userofmeet/TaRANG/README.md

# TaRANG

This repository contains the work I do at EMSys Lab, IIT Bombay, as a Research Assistant during my master's, under the guidance of Prof. Maryam Shojaei Baghini.

It serves as a place to keep the datasheets, research papers, code, and other technical resources related to my work.

## Contents

- Datasheets and technical documentation
- Research papers and references
- Code and implementations
- Experiments and analysis
- Notes and other useful resources

The repository will be updated as I continue working on different tasks and projects in the lab.
