userofmeet/TaRANG/MagniSense_Sys_1V1/Readings/output/print_02_plot.png

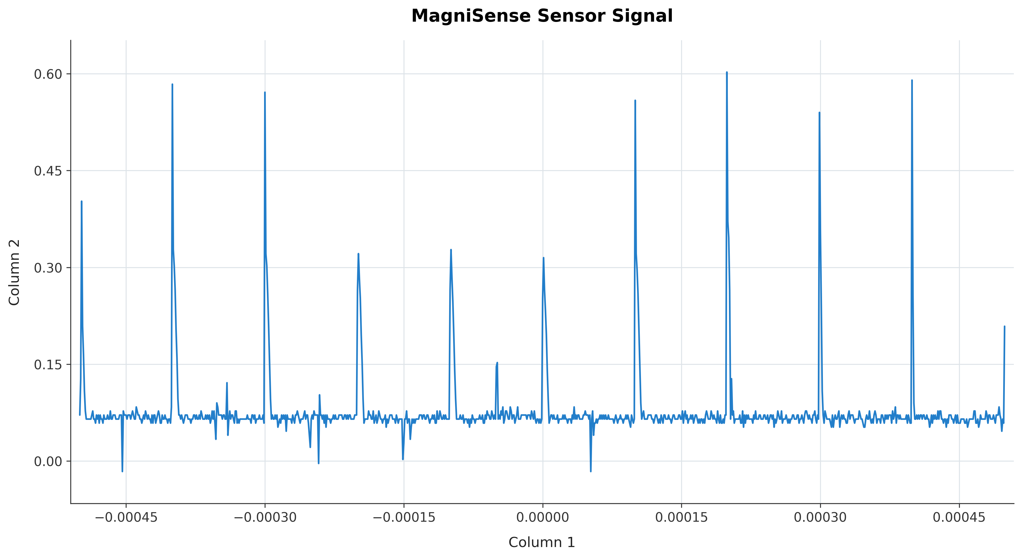
MagniSense_Sys_1V1/Readings/output/print_02_plot.png
