userofmeet/TaRANG/MagniSense_Sys_1V1/Readings/output/print_03_plot.png

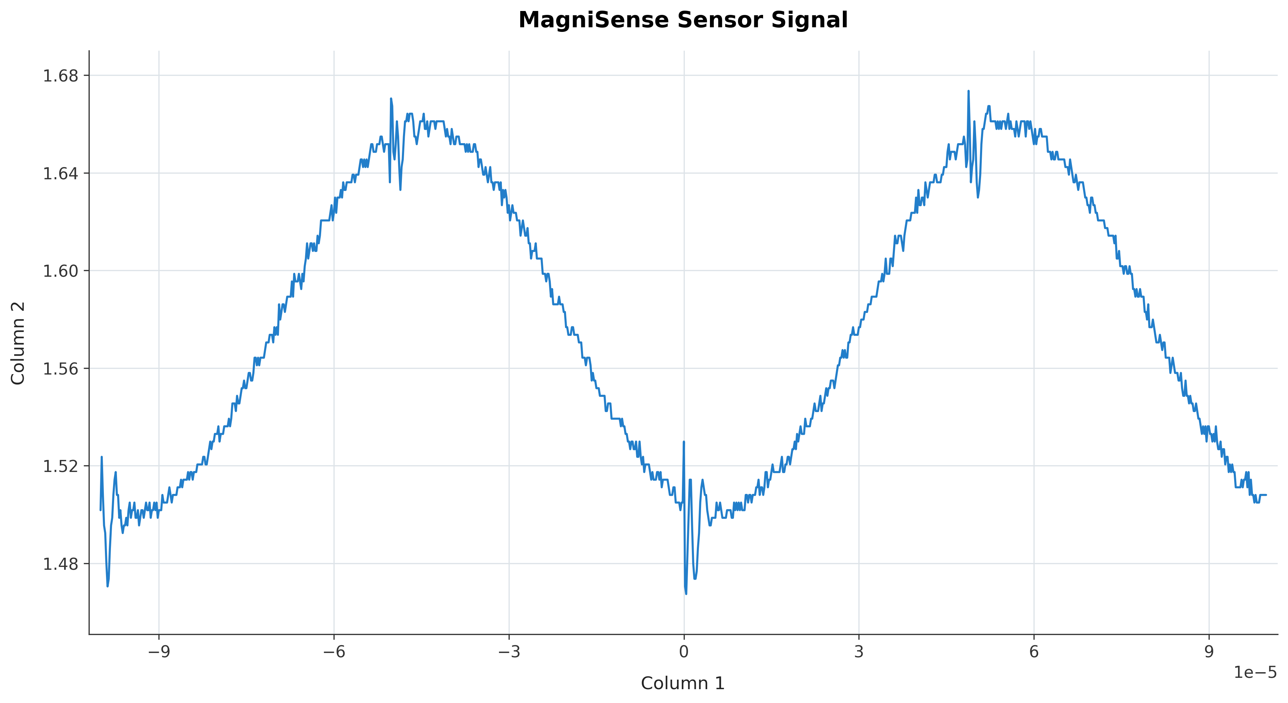
MagniSense_Sys_1V1/Readings/output/print_03_plot.png
