userofmeet/TaRANG/MagniSense_Sys_1V1/INA_Characterization.xlsx

INA1 CHARACTERIZATION MAGNISENSE V1 |  |  |  |  |  | INA1 CHARACTERIZATION MAGNISENSE V1
 | p2p | max(m) | min(m) | DC offset | VERDICT |  | p2p | max | min | DC offset | VERDICT | unit
50 | 0.06331 | 0.37488 | 0.31157 | 0.343225 | COMPLETELY SATURATED | 50 | 0.01 | 3.24 | 3.23 | 3.235 | SATURATION | (v)
1K | 0.01 | 0.51151 | 0.3249 | 0.418205 | COMPLETELY SATURATED | 1K | 0 |  |  | 0
2K | 0.18661 | 0.4282 | 0.4182 | 0.4232 | COMPLETELY SATURATED | 2K | 0 |  |  | 0
4K | 0.41098 | 0.66932 | 0.25834 | 0.46383 | SATURATED | 4K | 0 |  |  | 0
6K | 0.950729 | 0.97423 | 0.023501 | 0.4988655 | SATURATED | 6K | 0 |  |  | 0
8K | 0.98137 | 1.1425 | 0.16113 | 0.651815 |  | 8K | 0 |  |  | 0
10K | 0.68019 | 1.1239 | 0.44371 | 0.783805 |  | 10K | 0 |  |  | 0
15K | 0.60348 | 1.3651 | 0.76162 | 1.06336 |  | 15K | 0 |  |  | 0
20K | 0.47082 | 1.4044 | 0.93358 | 1.16899 |  | 20K | 0 |  |  | 0
25K | 0.4192 | 1.4501 | 1.0309 | 1.2405 |  | 25K | 0 |  |  | 0
30K | 0.3642 | 1.4684 | 1.1042 | 1.2863 |  | 30K | 0 |  |  | 0
35K | 0.3316 | 1.4861 | 1.1545 | 1.3203 |  | 35K | 0 |  |  | 0
40K | 0.3139 | 1.4967 | 1.1828 | 1.33975 |  | 40K | 1.46 | 3.28 | 1.82 | 2.55 |  | v
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
