userofmeet/TaRANG/MagniSense_Sys_1V1/DigiPOT/digipot_characterization.csv

sent_res_kohm | expected_res_kohm | measured_dmm_kohm | measured_smd_kohm
2.570 | 2.589 | 2.446 | 2.448
3.070 | 2.980 | 2.812 | 2.820
3.570 | 3.565 | 3.290 | 3.320
4.070 | 4.151 | 3.855 | 3.840
4.570 | 4.542 | 4.220 | 4.230
4.490 | 4.542 | 4.220 | 4.240
4.990 | 4.932 | 4.580 | 4.610
5.490 | 5.518 | 5.130 | 5.130
5.990 | 5.909 | 5.490 | 5.500
6.490 | 6.495 | 6.080 | 6.100
11.400 | 11.378 | 10.680 | 10.740
11.900 | 11.964 | 11.230 | 11.280
12.400 | 12.354 | 11.610 | 11.650
12.900 | 12.940 | 12.200 | 12.210
13.400 | 13.331 | 12.560 | 12.620
48.400 | 48.487 | 45.300 | 45.500
48.900 | 48.878 | 45.600 | 45.900
49.400 | 49.464 | 46.200 | 46.400
49.900 | 49.854 | 46.600 | 46.800
50.400 | 49.854 | 46.600 | 46.800
