userofmeet/TaRANG/MagniSense_Sys_1V1/DigiPOT/digipot_characterization.xlsx

EXPECTED RES | CALCULATED RES | MEASURED RES DMM | MEASURED RES SMD | VALUE AFTER CALIB |  | RES MEASURED (SMD)
2.57K | 2.589K | 2.446K | 2.448K
3.07K | 2.98K | 2.812K | 2.82K
3.57K | 3.565K | 3.29K | 3.32K | 3750 | 3950 | 3.47K | 3.65K
4.07k | 4.151K | 3.855K | 3.84K
4.57K | 4.542K | 4.22K | 4.23K
4.49K | 4.542K | 4.22K | 4.24K
4.99K | 4.932K | 4.58K | 4.61K
5.49K | 5.518K | 5.13K | 5.13K | 5800 | 5900 | 5.33K | 5.50K
5.99K | 5.909K | 5.49K | 5.5K
6.49K | 6.495K | 6.08K | 6.1K
11.4K | 11.378K | 10.68K | 10.74K
11.9K | 11.964K | 11.23K | 11.28K
12.4K | 12.354K | 11.61K | 11.65K | 13000 | 13080 | 12.22K | 12.41K
12.9K | 12.94K | 12.20K | 12.21K
13.4K | 13.331K | 12.56K | 12.62K
48.4K | 48.487K | 45.3K | 45.5K
48.9K | 48.878K | 45.6K | 45.9K
49.4K | 49.464K | 46.2K | 46.4K | 50000 |  | 46.8K
49.9K | 49.854K | 46.6K | 46.8K
50.4K | 49.854K | 46.6K | 46.8K
