userofmeet/TaRANG/MagniSense_Sys_1V1/DigiPOT/dmm_calibration.png

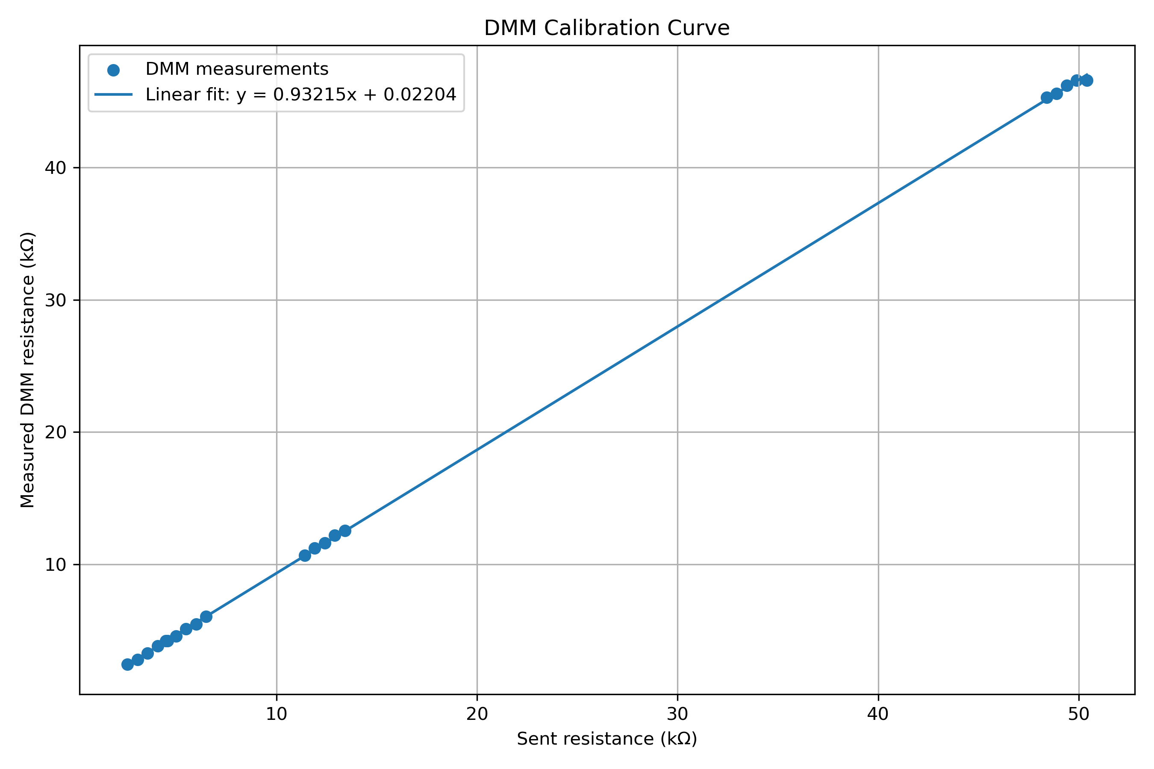
MagniSense_Sys_1V1/DigiPOT/dmm_calibration.png
