userofmeet/TaRANG/MagniSense_Sys_1V1/MagniS4ense_Sys_1V1.pdf

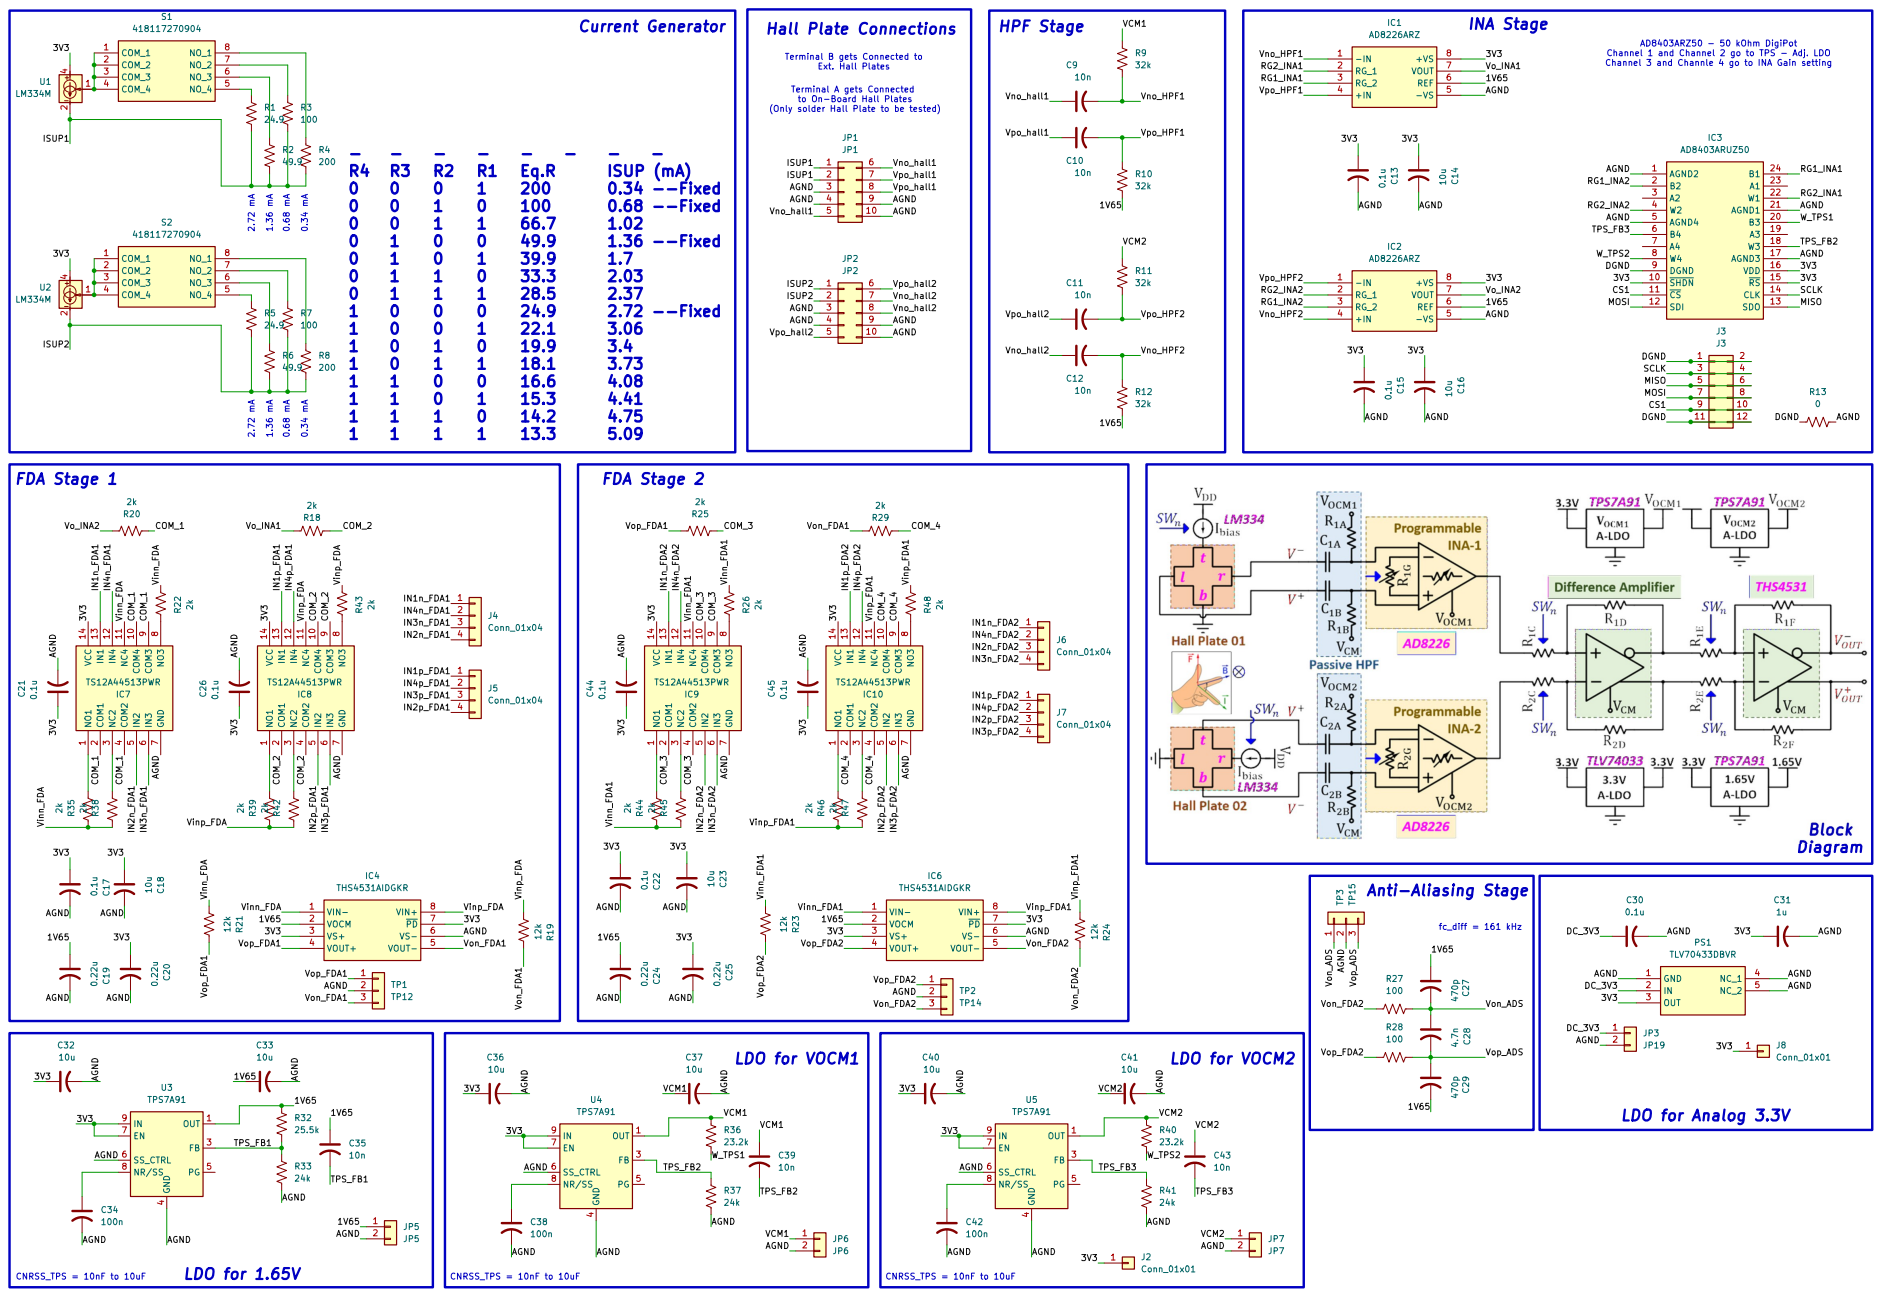
[picture p6: page 1]
