userofmeet/TaRANG/MagniSense_Sys_1V1/PCB/MagniSense_System_Emsys_IITB_1V1.kicad_pcb

## KiCad design MagniSense_Sys_1V1/PCB/MagniSense_System_Emsys_IITB_1V1.kicad_pcb (2026-10-28)

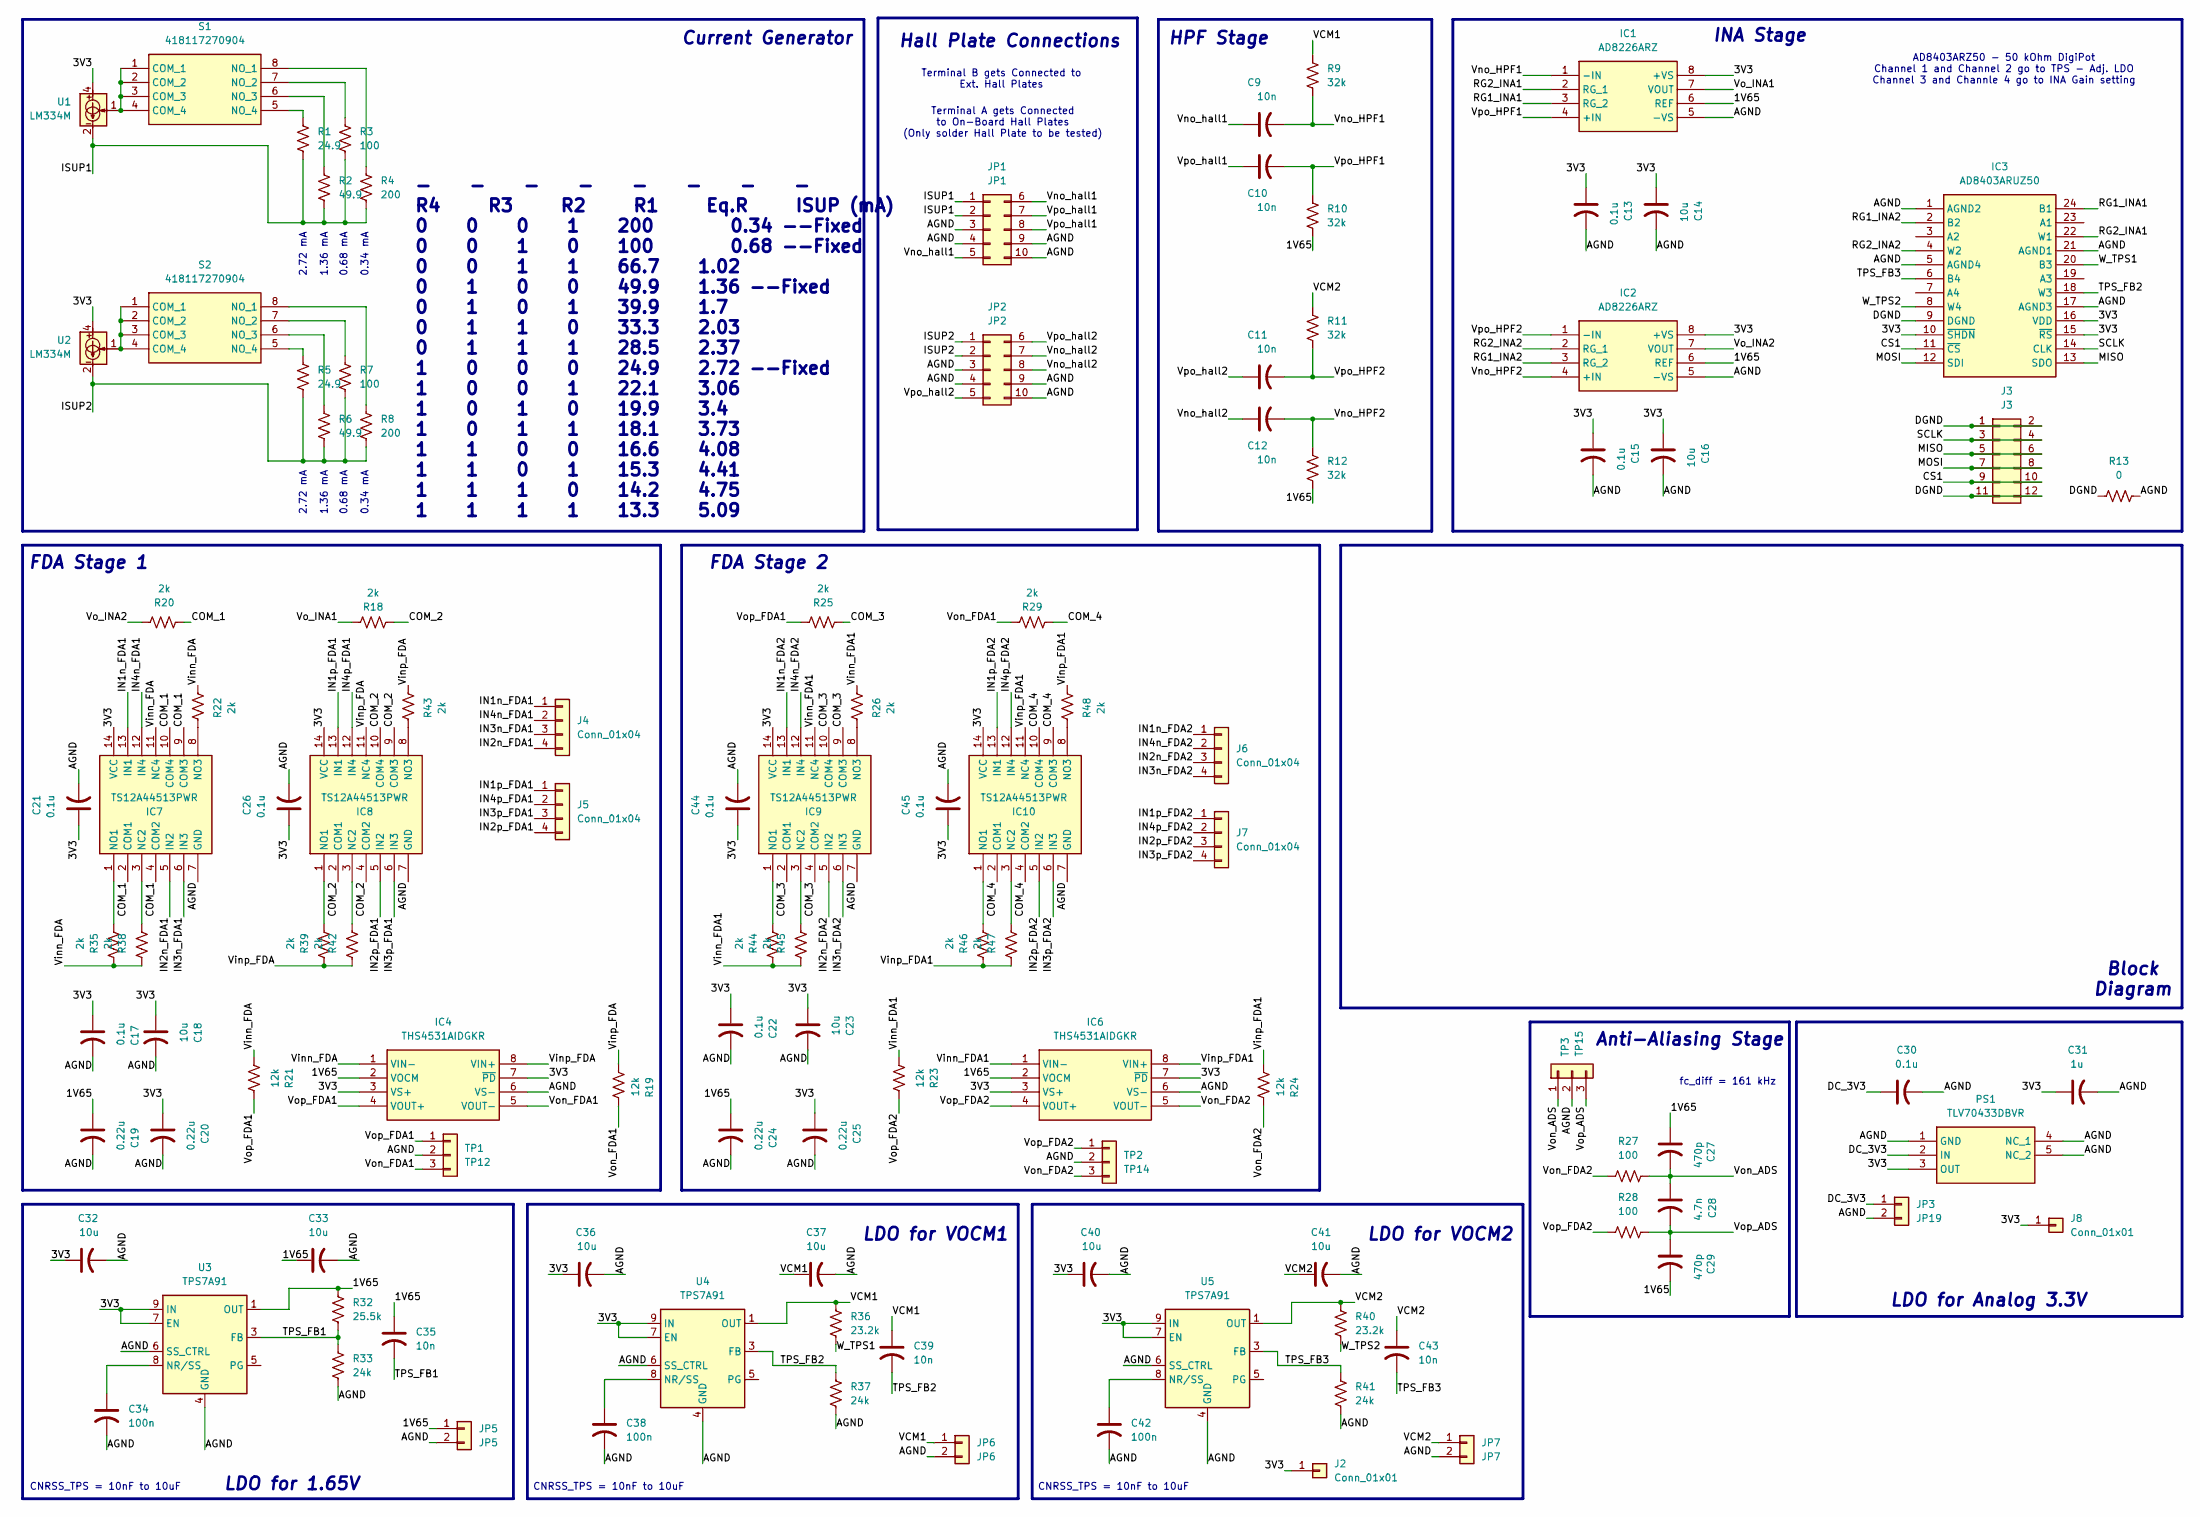
[picture p7: schematic MagniSense_System_Emsys_IITB_1V1.kicad_sch, MagniSesne_System_Emsys_IITB_1V1]

Parts:
C9, C10, C11, C12, C35, C39, C43: 10n; C_0603_1608Metric
C13, C15, C17, C21, C22, C26, C30, C44, C45: 0.1u; C_0603_1608Metric
C14, C16, C18, C23, C32, C33, C36, C37, C40, C41: 10u; C_0603_1608Metric
C19, C20, C24, C25: 0.22u; C_0603_1608Metric
C27, C29: 470p; C_0603_1608Metric
C28: 4.7n; C_0603_1608Metric
C31: 1u; C_0603_1608Metric
C34, C38, C42: 100n; C_0603_1608Metric
IC1, IC2: AD8226ARZ; SOIC127P600X175-8N; Manufacturer_Part_Number AD8226ARZ; Mouser Part Number 584-AD8226ARZ
IC3: AD8403ARUZ50; SOP65P640X120-24N; Manufacturer_Part_Number AD8403ARUZ50; Mouser Part Number 584-AD8403ARUZ50
IC4, IC6: THS4531AIDGKR; SOP65P490X110-8N; Manufacturer_Part_Number THS4531AIDGKR; Mouser Part Number 595-THS4531AIDGKR
IC7, IC8, IC9, IC10: TS12A44513PWR; SOP65P640X120-14N; Manufacturer_Part_Number TS12A44513PWR; Mouser Part Number 595-TS12A44513PWR
J2, J8: Conn_01x01; PinHeader_1x01_P2.54mm_Vertical
J3: J3; PinHeader_2x06_P2.54mm_Vertical
J4, J5, J6, J7: Conn_01x04; PinHeader_1x04_P2.54mm_Vertical
JP1: JP1; PinHeader_2x05_P2.54mm_Vertical
JP2: JP2; PinHeader_2x05_P2.54mm_Vertical
JP3: JP19; PinHeader_1x02_P2.54mm_Vertical
JP5: JP5; PinHeader_1x02_P2.54mm_Vertical
JP6: JP6; PinHeader_1x02_P2.54mm_Vertical
JP7: JP7; PinHeader_1x02_P2.54mm_Vertical
PS1: TLV70433DBVR; SOT95P280X145-5N; Manufacturer_Part_Number TLV70433DBVR; Mouser Part Number 595-TLV70433DBVR
R1, R5: 24.9; R_0603_1608Metric
R2, R6: 49.9; R_0603_1608Metric
R3, R7, R27, R28: 100; R_0603_1608Metric
R4, R8: 200; R_0603_1608Metric
R9, R10, R11, R12: 32k; R_0603_1608Metric
R13: 0; R_0603_1608Metric
R18, R20, R22, R25, R26, R29, R35, R38, R39, R42, R43, R44, R45, R46, R47, R48: 2k; R_0603_1608Metric
R19, R21, R23, R24: 12k; R_0603_1608Metric
R32: 25.5k; R_0603_1608Metric
R33, R37, R41: 24k; R_0603_1608Metric
R36, R40: 23.2k; R_0603_1608Metric
S1, S2: 418117270904; Manufacturer_Part_Number 418117270904; Mouser Part Number 710-418117270904
TP1: TP12; PinHeader_1x03_P2.54mm_Vertical
TP2: TP14; PinHeader_1x03_P2.54mm_Vertical
TP3: TP15; PinHeader_1x03_P2.54mm_Vertical
U1, U2: LM334M; SOIC-8_3.9x4.9mm_P1.27mm
U3, U4, U5: TPS7A91; Texas_S-PDSO-N10_EP1.2x2mm

Connections:
/1V65: C19.1, C24.1, C27.1, C29.2, C33.1, C35.1, IC1.6 (REF), IC2.6 (REF), IC4.2 (VOCM), IC6.2 (VOCM), JP5.1, R10.2, R12.2, R32.1, U3.1 (OUT), U3.2 (OUT)
/3V3: C13.1, C14.1, C15.1, C16.1, C17.1, C18.1, C20.1, C21.1, C22.1, C23.1, C25.1, C26.1, C31.1, C32.1, C36.1, C40.1, C44.1, C45.1, IC1.8 (+VS), IC2.8 (+VS), IC3.10 (~SHDN), IC3.15 (~RS), IC3.16 (VDD), IC4.3 (VS+), IC4.7 (~PD), IC6.3 (VS+), IC6.7 (~PD), IC7.14 (VCC), IC8.14 (VCC), IC9.14 (VCC), IC10.14 (VCC), J2.1 (Pin_1_1), J8.1 (Pin_1_1), PS1.3 (OUT), U1.4, U2.4, U3.7 (EN), U3.9 (IN), U3.10 (IN), U4.7 (EN), U4.9 (IN), U4.10 (IN), U5.7 (EN), U5.9 (IN), U5.10 (IN)
/AGND: C13.2, C14.2, C15.2, C16.2, C17.2, C18.2, C19.2, C20.2, C21.2, C22.2, C23.2, C24.2, C25.2, C26.2, C30.2, C31.2, C32.2, C33.2, C34.2, C36.2, C37.2, C38.2, C40.2, C41.2, C42.2, C44.2, C45.2, IC1.5 (-VS), IC2.5 (-VS), IC3.1 (AGND2), IC3.5 (AGND4), IC3.17 (AGND3), IC3.21 (AGND1), IC4.6 (VS-), IC6.6 (VS-), IC7.7 (GND), IC8.7 (GND), IC9.7 (GND), IC10.7 (GND), JP1.3, JP1.4, JP1.9, JP1.10, JP2.3, JP2.4, JP2.9, JP2.10, JP3.2, JP5.2, JP6.2, JP7.2, PS1.1 (GND), PS1.4 (NC_1), PS1.5 (NC_2), R13.2, R33.2, R37.2, R41.2, TP1.2, TP2.2, TP3.2, U3.4 (GND), U3.6 (SS_CTRL), U3.11 (GND), U4.4 (GND), U4.6 (SS_CTRL), U4.11 (GND), U5.4 (GND), U5.6 (SS_CTRL), U5.11 (GND)
/COM_1: IC7.2 (COM1), IC7.4 (COM2), IC7.9 (COM3), IC7.10 (COM4), R20.2
/COM_2: IC8.2 (COM1), IC8.4 (COM2), IC8.9 (COM3), IC8.10 (COM4), R18.1
/COM_3: IC9.2 (COM1), IC9.4 (COM2), IC9.9 (COM3), IC9.10 (COM4), R25.2
/COM_4: IC10.2 (COM1), IC10.4 (COM2), IC10.9 (COM3), IC10.10 (COM4), R29.1
/CS1: IC3.11 (~CS), J3.9, J3.10
/DC_3V3: C30.1, JP3.1, PS1.2 (IN)
/DGND: IC3.9 (DGND), J3.1, J3.2, J3.11, J3.12, R13.1
/IN1n_FDA1: IC7.13 (IN1), J4.1
/IN1n_FDA2: IC9.13 (IN1), J6.1
/IN1p_FDA1: IC8.13 (IN1), J5.1
/IN1p_FDA2: IC10.13 (IN1), J7.1
/IN2n_FDA1: IC7.5 (IN2), J4.4
/IN2n_FDA2: IC9.5 (IN2), J6.3
/IN2p_FDA1: IC8.5 (IN2), J5.4
/IN2p_FDA2: IC10.5 (IN2), J7.3
/IN3n_FDA1: IC7.6 (IN3), J4.3
/IN3n_FDA2: IC9.6 (IN3), J6.4
/IN3p_FDA1: IC8.6 (IN3), J5.3
/IN3p_FDA2: IC10.6 (IN3), J7.4
/IN4n_FDA1: IC7.12 (IN4), J4.2
/IN4n_FDA2: IC9.12 (IN4), J6.2
/IN4p_FDA1: IC8.12 (IN4), J5.2
/IN4p_FDA2: IC10.12 (IN4), J7.2
/ISUP1: JP1.1, JP1.2, R1.1, R2.1, R3.1, R4.2, U1.2, U1.3, U1.6, U1.7
/ISUP2: JP2.1, JP2.2, R5.1, R6.1, R7.1, R8.2, U2.2, U2.3, U2.6, U2.7
/MISO: IC3.13 (SDO), J3.5, J3.6
/MOSI: IC3.12 (SDI), J3.7, J3.8
/RG1_INA1: IC1.3 (RG_2), IC3.24 (B1)
/RG1_INA2: IC2.3 (RG_2), IC3.2 (B2)
/RG2_INA1: IC1.2 (RG_1), IC3.22 (W1)
/RG2_INA2: IC2.2 (RG_1), IC3.4 (W2)
/SCLK: IC3.14 (CLK), J3.3, J3.4
/TPS_FB1: C35.2, R32.2, R33.1, U3.3 (FB)
/TPS_FB2: C39.2, IC3.18 (W3), R37.1, U4.3 (FB)
/TPS_FB3: C43.2, IC3.6 (B4), R41.1, U5.3 (FB)
/VCM1: C37.1, C39.1, JP6.1, R9.1, R36.1, U4.1 (OUT), U4.2 (OUT)
/VCM2: C41.1, C43.1, JP7.1, R11.1, R40.1, U5.1 (OUT), U5.2 (OUT)
/Vinn_FDA: IC4.1 (VIN-), IC7.11 (NC4), R21.1, R22.1, R35.1, R38.1
/Vinn_FDA1: IC6.1 (VIN-), IC9.11 (NC4), R23.1, R26.1, R44.1, R45.1
/Vinp_FDA: IC4.8 (VIN+), IC8.11 (NC4), R19.1, R39.1, R42.1, R43.1
/Vinp_FDA1: IC6.8 (VIN+), IC10.11 (NC4), R24.1, R46.1, R47.1, R48.1
/Vno_HPF1: C9.2, IC1.1 (-IN), R9.2
/Vno_HPF2: C12.2, IC2.4 (+IN), R12.1
/Vno_hall1: C9.1, JP1.5, JP1.6
/Vno_hall2: C12.1, JP2.7, JP2.8
/Vo_INA1: IC1.7 (VOUT), R18.2
/Vo_INA2: IC2.7 (VOUT), R20.1
/Von_ADS: C27.2, C28.1, R27.2, TP3.1
/Von_FDA1: IC4.5 (VOUT-), R19.2, R29.2, TP1.3
/Von_FDA2: IC6.5 (VOUT-), R24.2, R27.1, TP2.3
/Vop_ADS: C28.2, C29.1, R28.2, TP3.3
/Vop_FDA1: IC4.4 (VOUT+), R21.2, R25.1, TP1.1
/Vop_FDA2: IC6.4 (VOUT+), R23.2, R28.1, TP2.1
/Vpo_HPF1: C10.2, IC1.4 (+IN), R10.1
/Vpo_HPF2: C11.2, IC2.1 (-IN), R11.2
/Vpo_hall1: C10.1, JP1.7, JP1.8
/Vpo_hall2: C11.1, JP2.5, JP2.6
/W_TPS1: IC3.20 (B3), R36.2
/W_TPS2: IC3.8 (W4), R40.2
unnamed: IC7.3 (NC2), R38.2
unnamed: IC7.1 (NO1), R35.2
unnamed: IC7.8 (NO3), R22.2
unnamed: IC8.3 (NC2), R42.2
unnamed: IC8.1 (NO1), R39.2
unnamed: IC8.8 (NO3), R43.2
unnamed: IC9.3 (NC2), R45.2
unnamed: IC9.1 (NO1), R44.2
unnamed: IC9.8 (NO3), R26.2
unnamed: IC10.3 (NC2), R47.2
unnamed: IC10.1 (NO1), R46.2
unnamed: IC10.8 (NO3), R48.2
unnamed: S1.1 (COM_1), S1.2 (COM_2), S1.3 (COM_3), S1.4 (COM_4), U1.1
unnamed: R4.1, S1.8 (NO_1)
unnamed: R3.2, S1.7 (NO_2)
unnamed: R2.2, S1.6 (NO_3)
unnamed: R1.2, S1.5 (NO_4)
unnamed: S2.1 (COM_1), S2.2 (COM_2), S2.3 (COM_3), S2.4 (COM_4), U2.1
unnamed: R8.1, S2.8 (NO_1)
unnamed: R7.2, S2.7 (NO_2)
unnamed: R6.2, S2.6 (NO_3)
unnamed: R5.2, S2.5 (NO_4)
unnamed: C34.1, U3.8 (NR/SS)
unnamed: C38.1, U4.8 (NR/SS)
unnamed: C42.1, U5.8 (NR/SS)

Notes on the sheet:
INA Stage
fc_diff = 161 kHz
2.72 mA
CNRSS_TPS = 10nF to 10uF
1.36 mA
0.34 mA
AD8403ARZ50 - 50 kOhm DigiPot Channel 1 and Channel 2 go to TPS - Adj. LDO Channel 3 and Channle 4 go to INA Gain setting
0.68 mA
Anti-Aliasing Stage
Current Generator
HPF Stage
LDO for VOCM1
Terminal B gets Connected to Ext. Hall Plates
Block Diagram
LDO for Analog 3.3V
LDO for 1.65V
FDA Stage 1
Hall Plate Connections
FDA Stage 2
Terminal A gets Connected to On-Board Hall Plates (Only solder Hall Plate to be tested)
LDO for VOCM2
- - - - - - - - R4 R3 R2 R1 Eq.R ISUP (mA) 0 0 0 1 200 0.34 --Fixed 0 0 1 0 100 0.68 --Fixed 0 0 1 1 66.7 1.02 0 1 0 0 49.9 1.36 --Fixed 0 1 0 1 39.9 1.7 0 1 1 0 33.3 2.03 0 1 1 1 28.5 2.37 1 0 0 0 24.9 2.72 --Fixed 1 0 0 1 22.1 3.06 1 0 1 0 19.9 3.4 1 0 1 1 18.1 3.73 1 1 0 0 16.6 4.08 1 1 0 1 15.3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

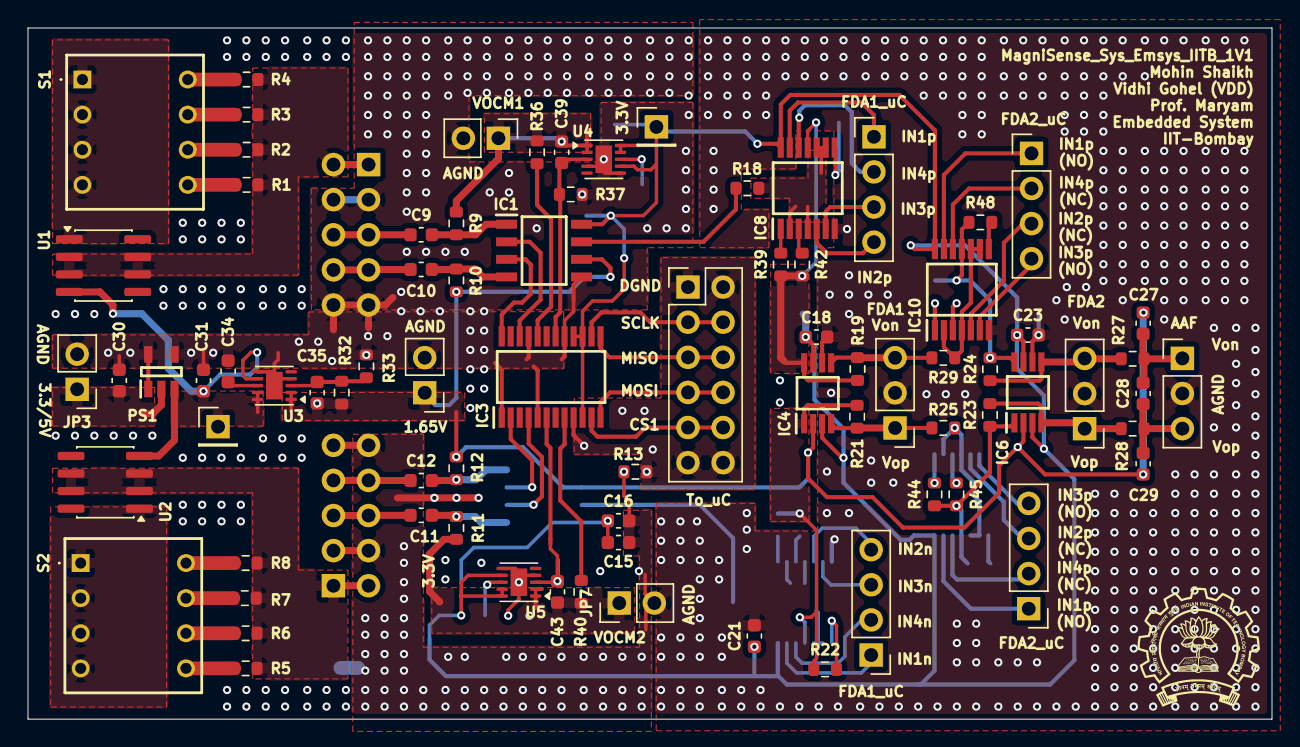
[picture p8: board MagniSense_System_Emsys_IITB_1V1.kicad_pcb from above]

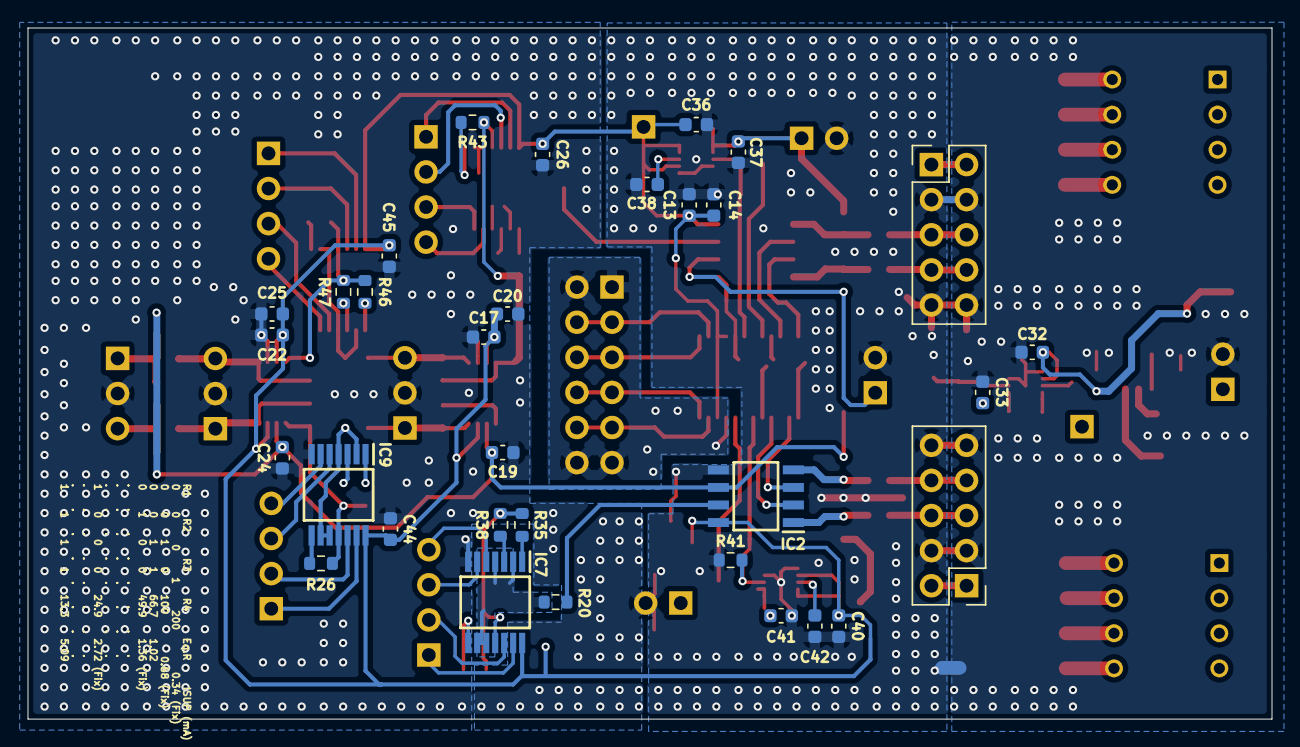
[picture p9: board MagniSense_System_Emsys_IITB_1V1.kicad_pcb from below]

Board: 2 copper layers, 90.0 x 50.0 mm, 111 parts (32 on the bottom side), 87 nets.
